KooroshTorabi/KMSwitch/docs/board-a-front.png

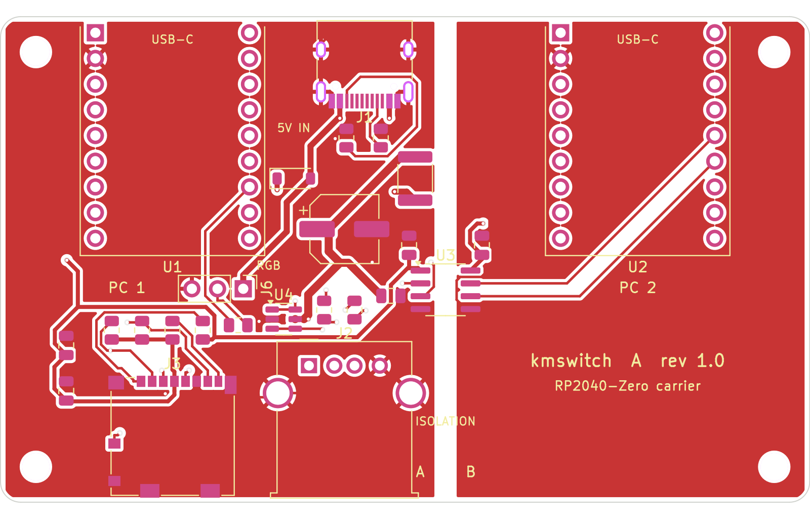
docs/board-a-front.png
