KooroshTorabi/KMSwitch/docs/case-a-back.png

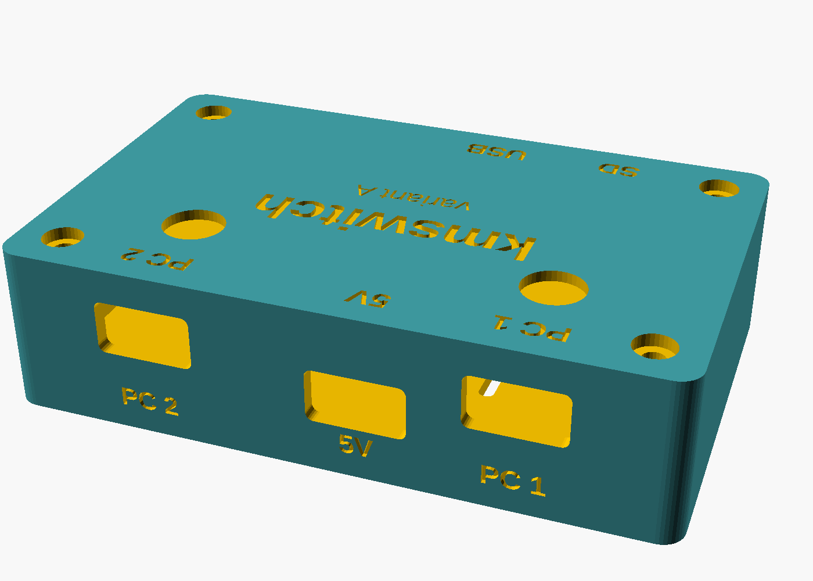
docs/case-a-back.png
