KooroshTorabi/KMSwitch/docs/case-a-front.png

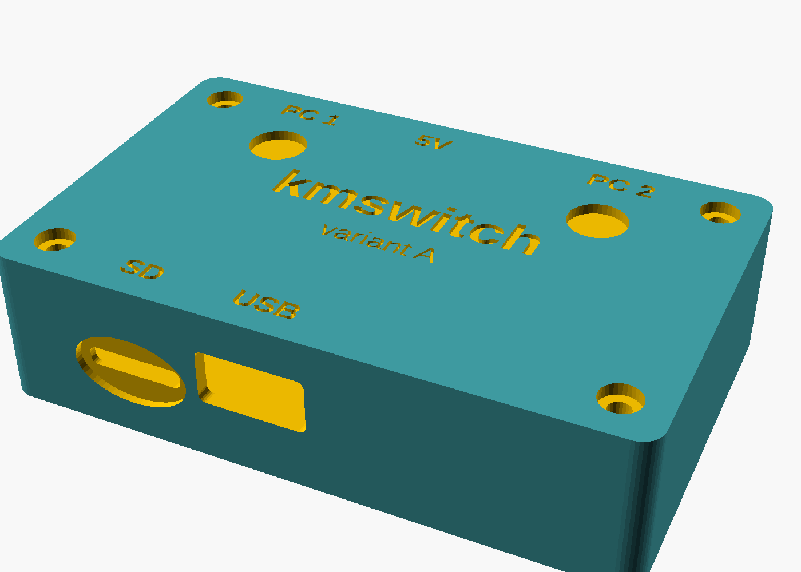
docs/case-a-front.png
