KooroshTorabi/KMSwitch/docs/case-b-back.png

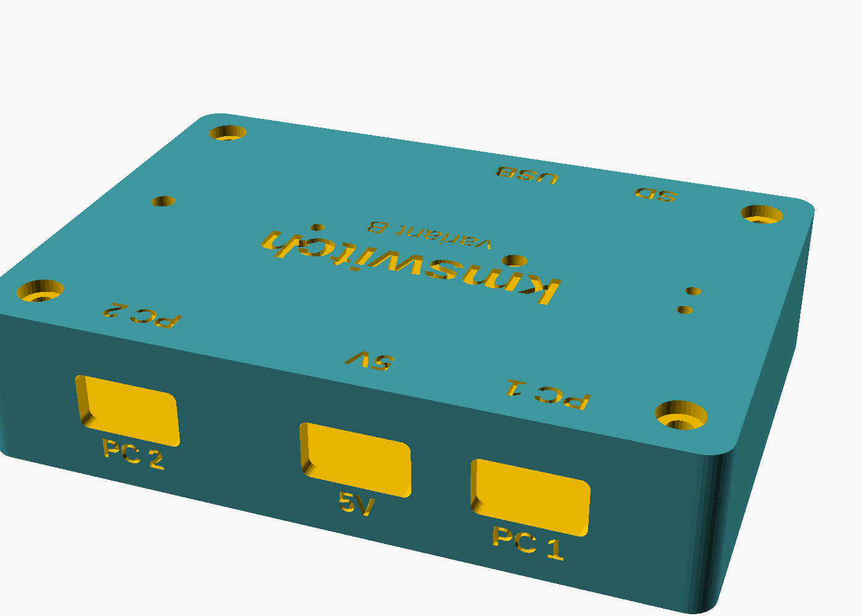
docs/case-b-back.png
