KooroshTorabi/KMSwitch/docs/case-b-front.png

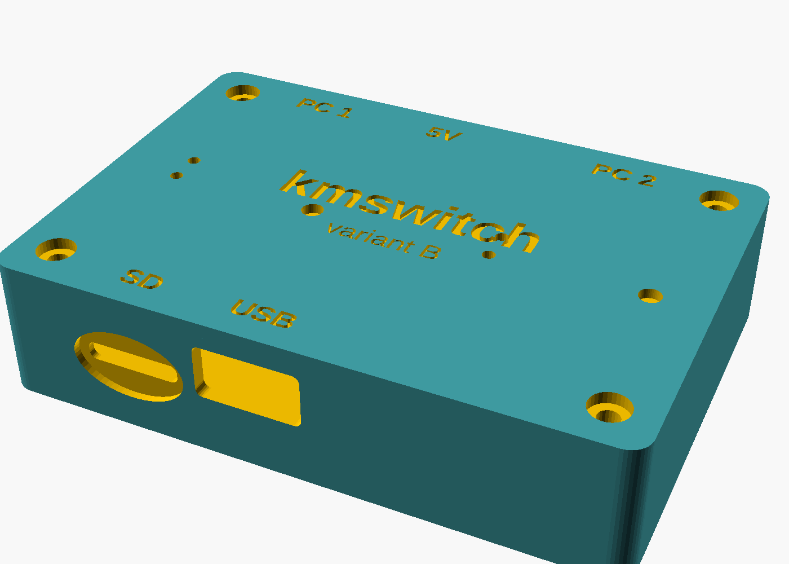
docs/case-b-front.png
