KooroshTorabi/KMSwitch/hardware/variant-a-rp2040-zero/fab/kmswitch-a-back.png

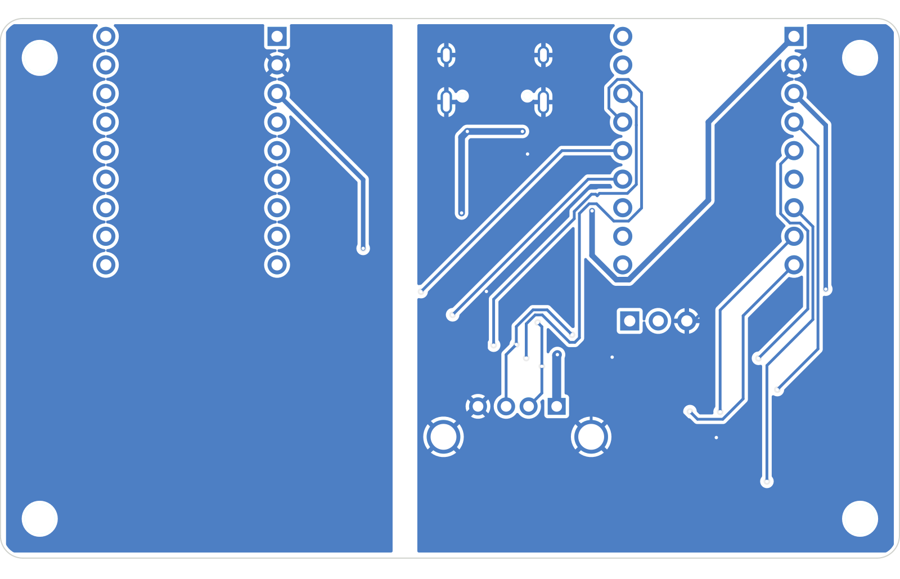
hardware/variant-a-rp2040-zero/fab/kmswitch-a-back.png
