KooroshTorabi/KMSwitch/hardware/variant-b-rp2040/fab/kmswitch-b-back.png

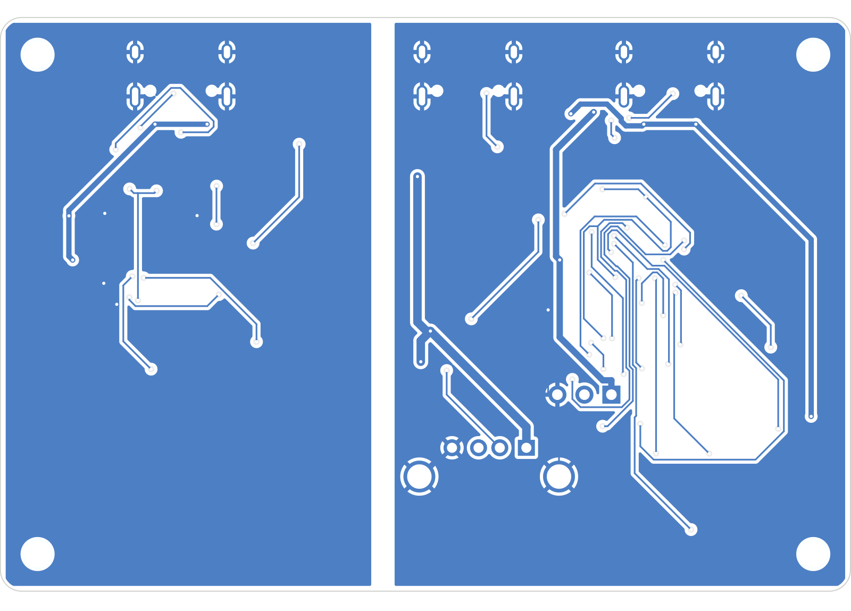
hardware/variant-b-rp2040/fab/kmswitch-b-back.png
