KooroshTorabi/KMSwitch/hardware/variant-b-rp2040/fab/kmswitch-b-bom.csv

Comment | Designator | Footprint | Quantity | LCSC Part # | Notes
100uF 10V | C1 | CP_Elec_6.3x7.7 | 1 | C294520 | VT1V101M-CRE77, 100uF 35V 6.3x7.7 (higher voltage is fine)
100nF | C2 | C_0805_2012Metric | 1 | C49678
100nF | C3,C4,C6,C14,C15,C16,C17,C18,C19,C20,C21,C24,C25,C54,C55,C56,C57,C58,C59,C60,C61,C64,C65 | C_0603_1608Metric | 23 | C14663
10uF | C5,C26,C27,C66,C67 | C_0805_2012Metric | 5 | C15850
15pF | C11,C12,C51,C52 | C_0603_1608Metric | 4 | C1644
1uF | C22,C23,C62,C63 | C_0603_1608Metric | 4 | C15849
SS34 | D2,D3 | D_SMA | 2 | C8678
red | D37,D77 | LED_0603_1608Metric | 2 | C2286 | KT-0603R
green | D38,D78 | LED_0603_1608Metric | 2 | C12624 | KT-0603G
blue | D39,D79 | LED_0603_1608Metric | 2 | C2288 | KT-0603B
2A hold (1812) | F1 | Fuse_1812_4532Metric | 1 | C545213 | SMD1812P200TF/16, 2A hold 16V
USB-C 5V IN | J1 | USB_C_Receptacle_HRO_TYPE-C-31-M-12 | 1 | C165948
USB-A host (hub/keyboard) | J2 | USB_A_Molex_67643_Horizontal | 1 | n/a | Molex 67643-0910 through-hole (Mouser/DigiKey/TME), hand-solder
104031-0811 | J3 | microSD_HC_Molex_104031-0811 | 1 | C585350
USB-C to PC 1 | J4 | USB_C_Receptacle_HRO_TYPE-C-31-M-12 | 1 | C165948
USB-C to PC 2 | J5 | USB_C_Receptacle_HRO_TYPE-C-31-M-12 | 1 | C165948
RGB LED (WS2812): 5V DIN GND | J6 | PinHeader_1x03_P2.54mm_Vertical | 1 | n/a | optional 3-pin header, not assembled (DNP)
5.1k | R1,R2 | R_0805_2012Metric | 2 | C27834
22R | R3,R4 | R_0603_1608Metric | 2 | C23345
10k | R5,R6,R7,R8,R32,R42,R72 | R_0603_1608Metric | 7 | C25804
330R | R9,R38,R78 | R_0603_1608Metric | 3 | C23138
1k | R13,R30,R37,R53,R70,R77 | R_0603_1608Metric | 6 | C21190
27R | R28,R29,R68,R69 | R_0603_1608Metric | 4 | C25190 | 0603WAF270JT5E
100R | R39,R79 | R_0603_1608Metric | 2 | C22775 | 0603WAF1000T5E
5.1k | R40,R41,R44,R45 | R_0603_1608Metric | 4 | C23186
20k | R43 | R_0603_1608Metric | 1 | C4184
BOOTSEL | SW31,SW71 | SW_SPST_PTS810 | 2 | C116501 | PTS810SJM250SMTRLFS
RESET | SW33,SW73 | SW_SPST_PTS810 | 2 | C116501 | PTS810SJM250SMTRLFS
CA-IS3721HS | U3 | SOIC-8_3.9x4.9mm_P1.27mm | 1 | C428884
USBLC6-2SC6 | U4,U5,U6 | SOT-23-6 | 3 | C7519
RP2040 | U10,U50 | QFN-56-1EP_7x7mm_P0.4mm_EP3.2x3.2mm | 2 | C2040
W25Q16JVSSIQ (2 MB) | U11,U51 | SOIC-8_5.23x5.23mm_P1.27mm | 2 | C131024
AP2112K-3.3 | U12,U52 | SOT-23-5 | 2 | C51118
12MHz | Y10,Y50 | Crystal_SMD_3225-4Pin_3.2x2.5mm | 2 | C9002
