KooroshTorabi/KMSwitch/enclosure/stl/kmswitch-b-lid.stl

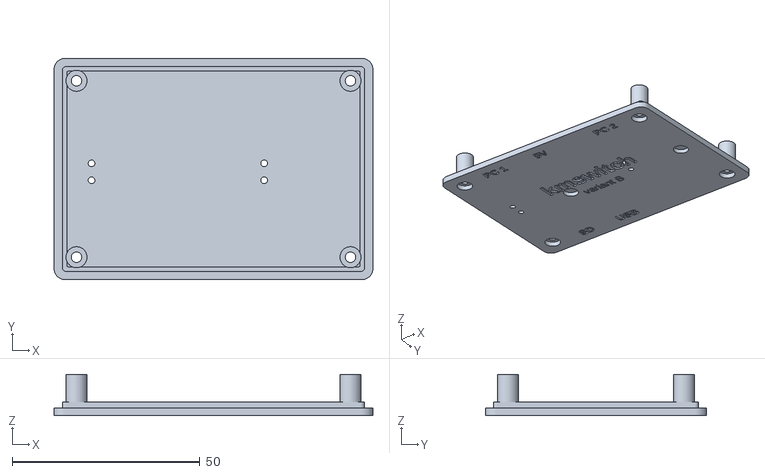
[picture p14: CAD file, 2026-11-04]
enclosure/stl/kmswitch-b-lid.stl
85.0 x 59.0 x 11.0
