KooroshTorabi/KMSwitch/enclosure/stl/kmswitch-a-lid.stl

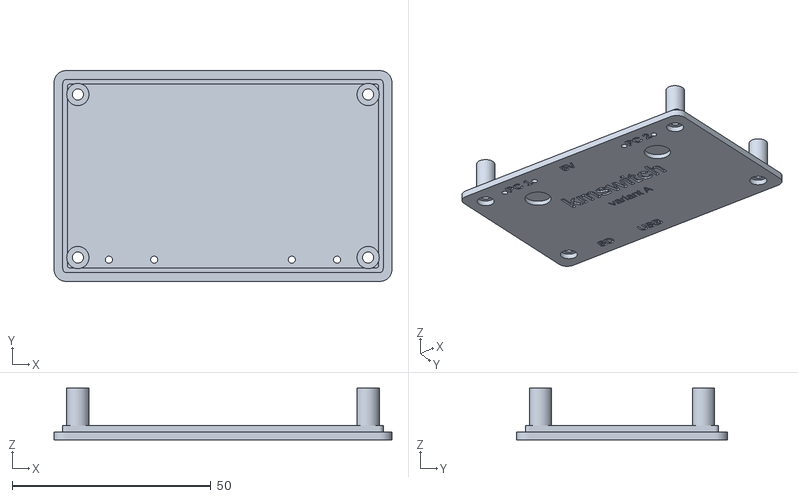
[picture p15: CAD file, 2026-11-04]
enclosure/stl/kmswitch-a-lid.stl
85.0 x 53.0 x 13.0
