KooroshTorabi/KMSwitch/enclosure/stl/kmswitch-b-bottom.stl

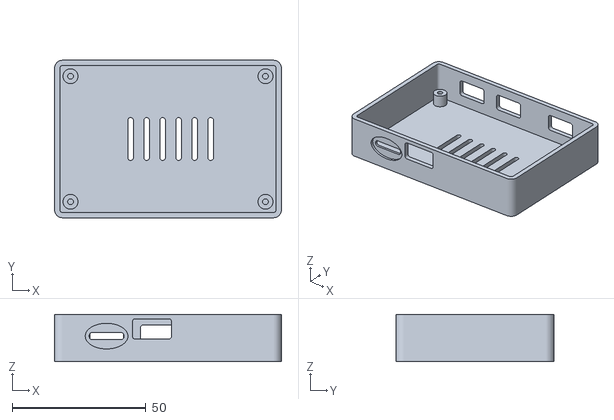
[picture p16: CAD file, 2026-11-02]
enclosure/stl/kmswitch-b-bottom.stl
85.0 x 59.0 x 17.6
