KooroshTorabi/KMSwitch/enclosure/stl/kmswitch-a-bottom.stl

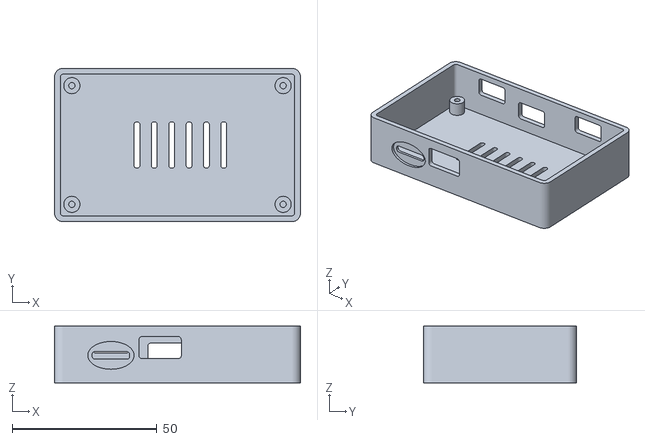
[picture p17: CAD file, 2026-11-02]
enclosure/stl/kmswitch-a-bottom.stl
85.0 x 53.0 x 19.6
