KooroshTorabi/KMSwitch/hardware/variant-a-rp2040-zero/fab/kmswitch-a-schematic.pdf

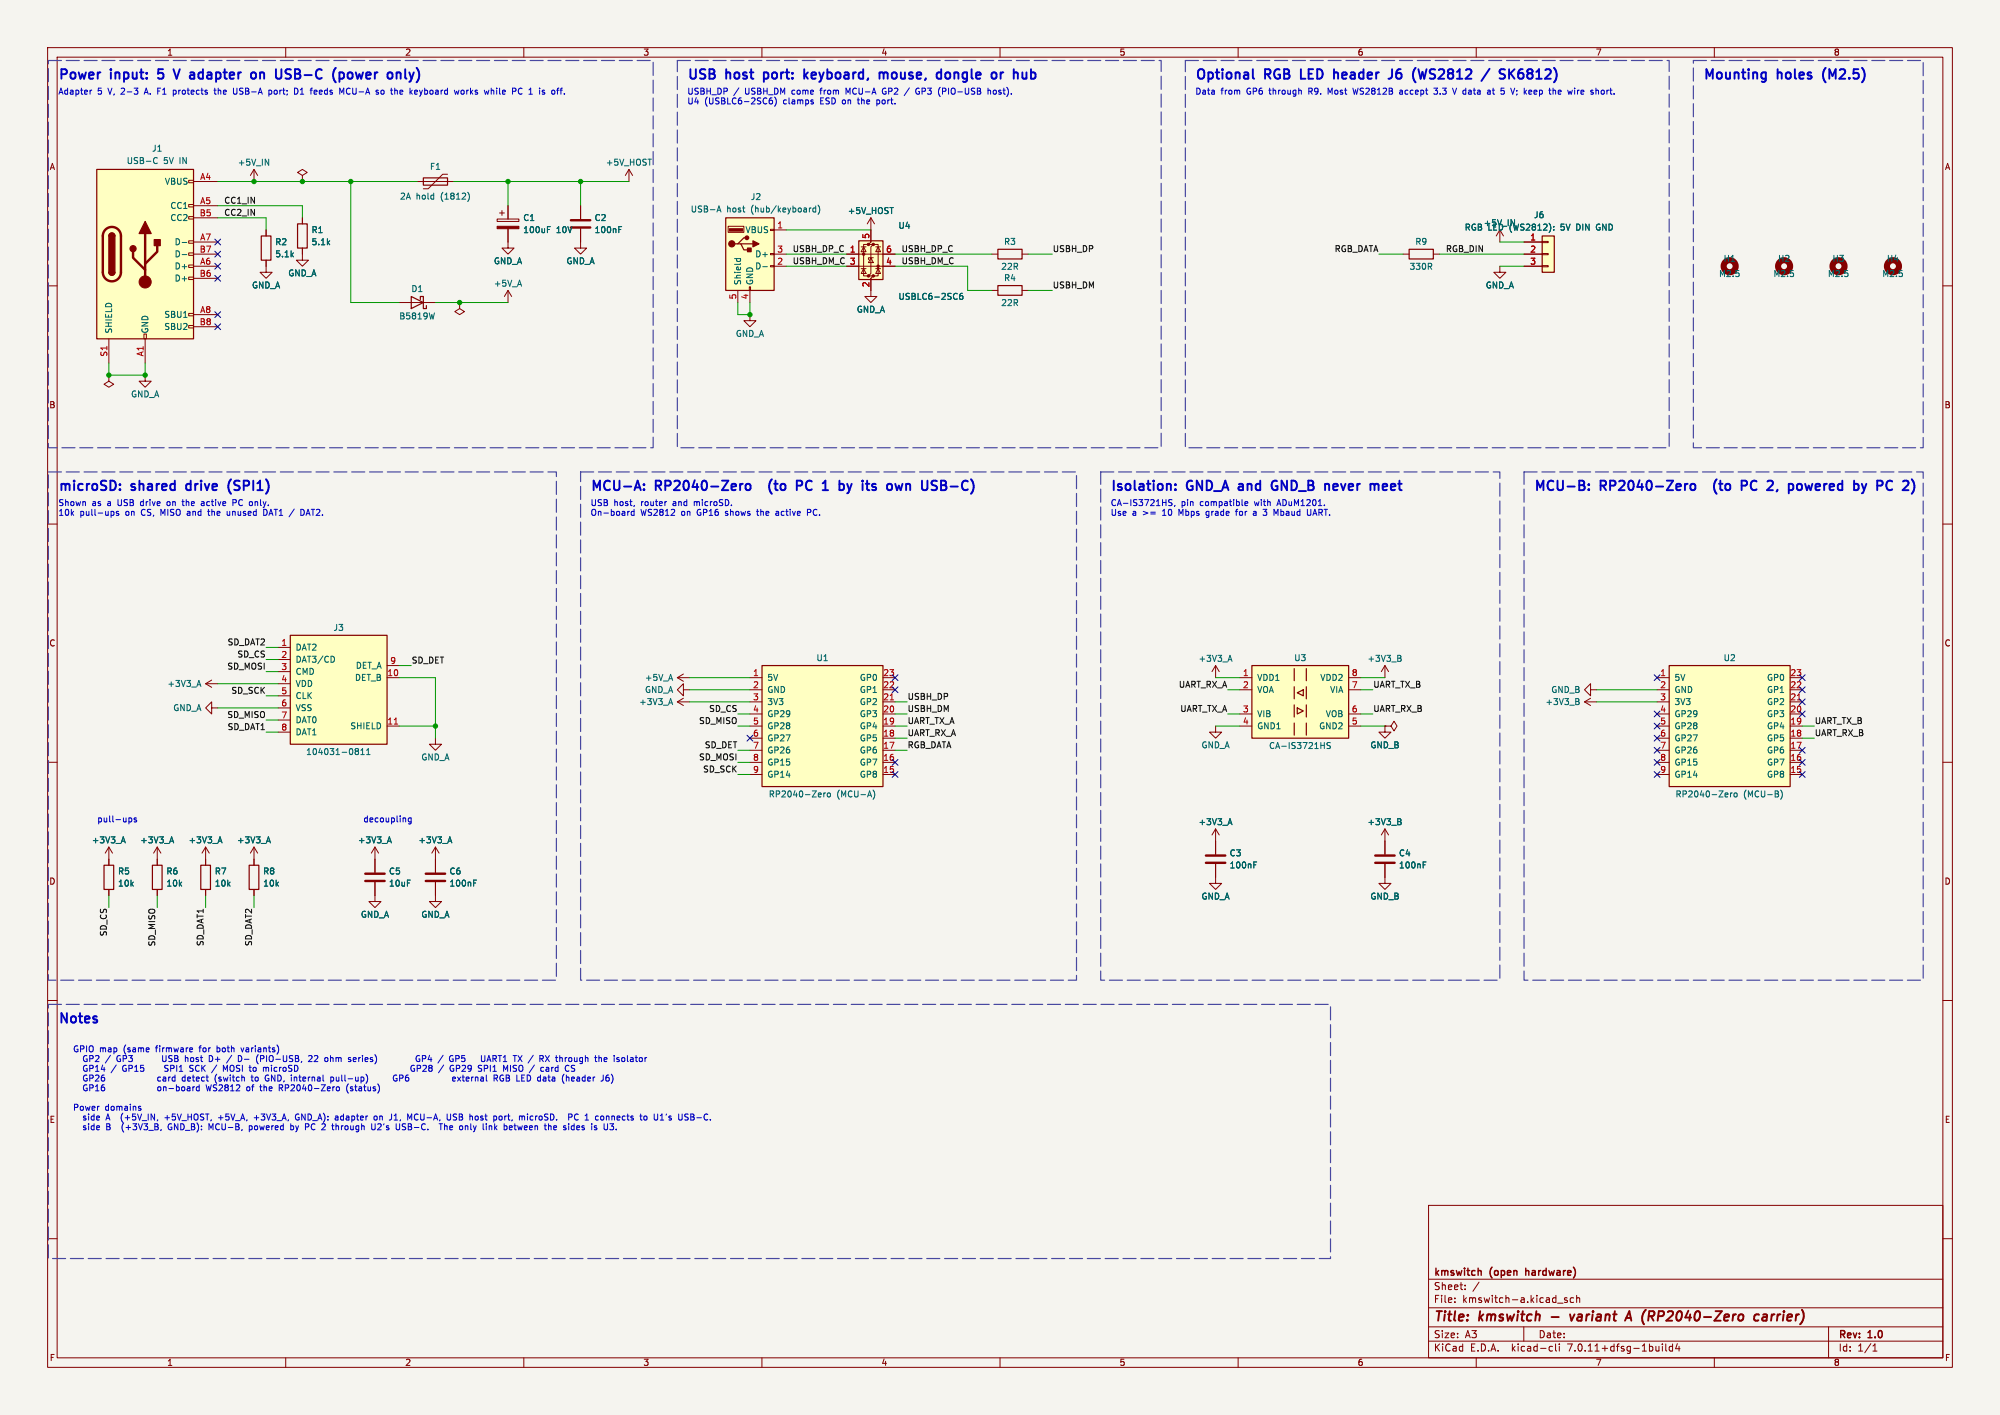
[picture p19: page 1]

USB host port: keyboard, mouse, dongle or hub

J2 USB-A host (hub/keyboard) R2
