KooroshTorabi/KMSwitch/hardware/variant-a-rp2040-zero/kmswitch-a.kicad_pcb

## KiCad design hardware/variant-a-rp2040-zero/kmswitch-a.kicad_pcb (2026-11-04)

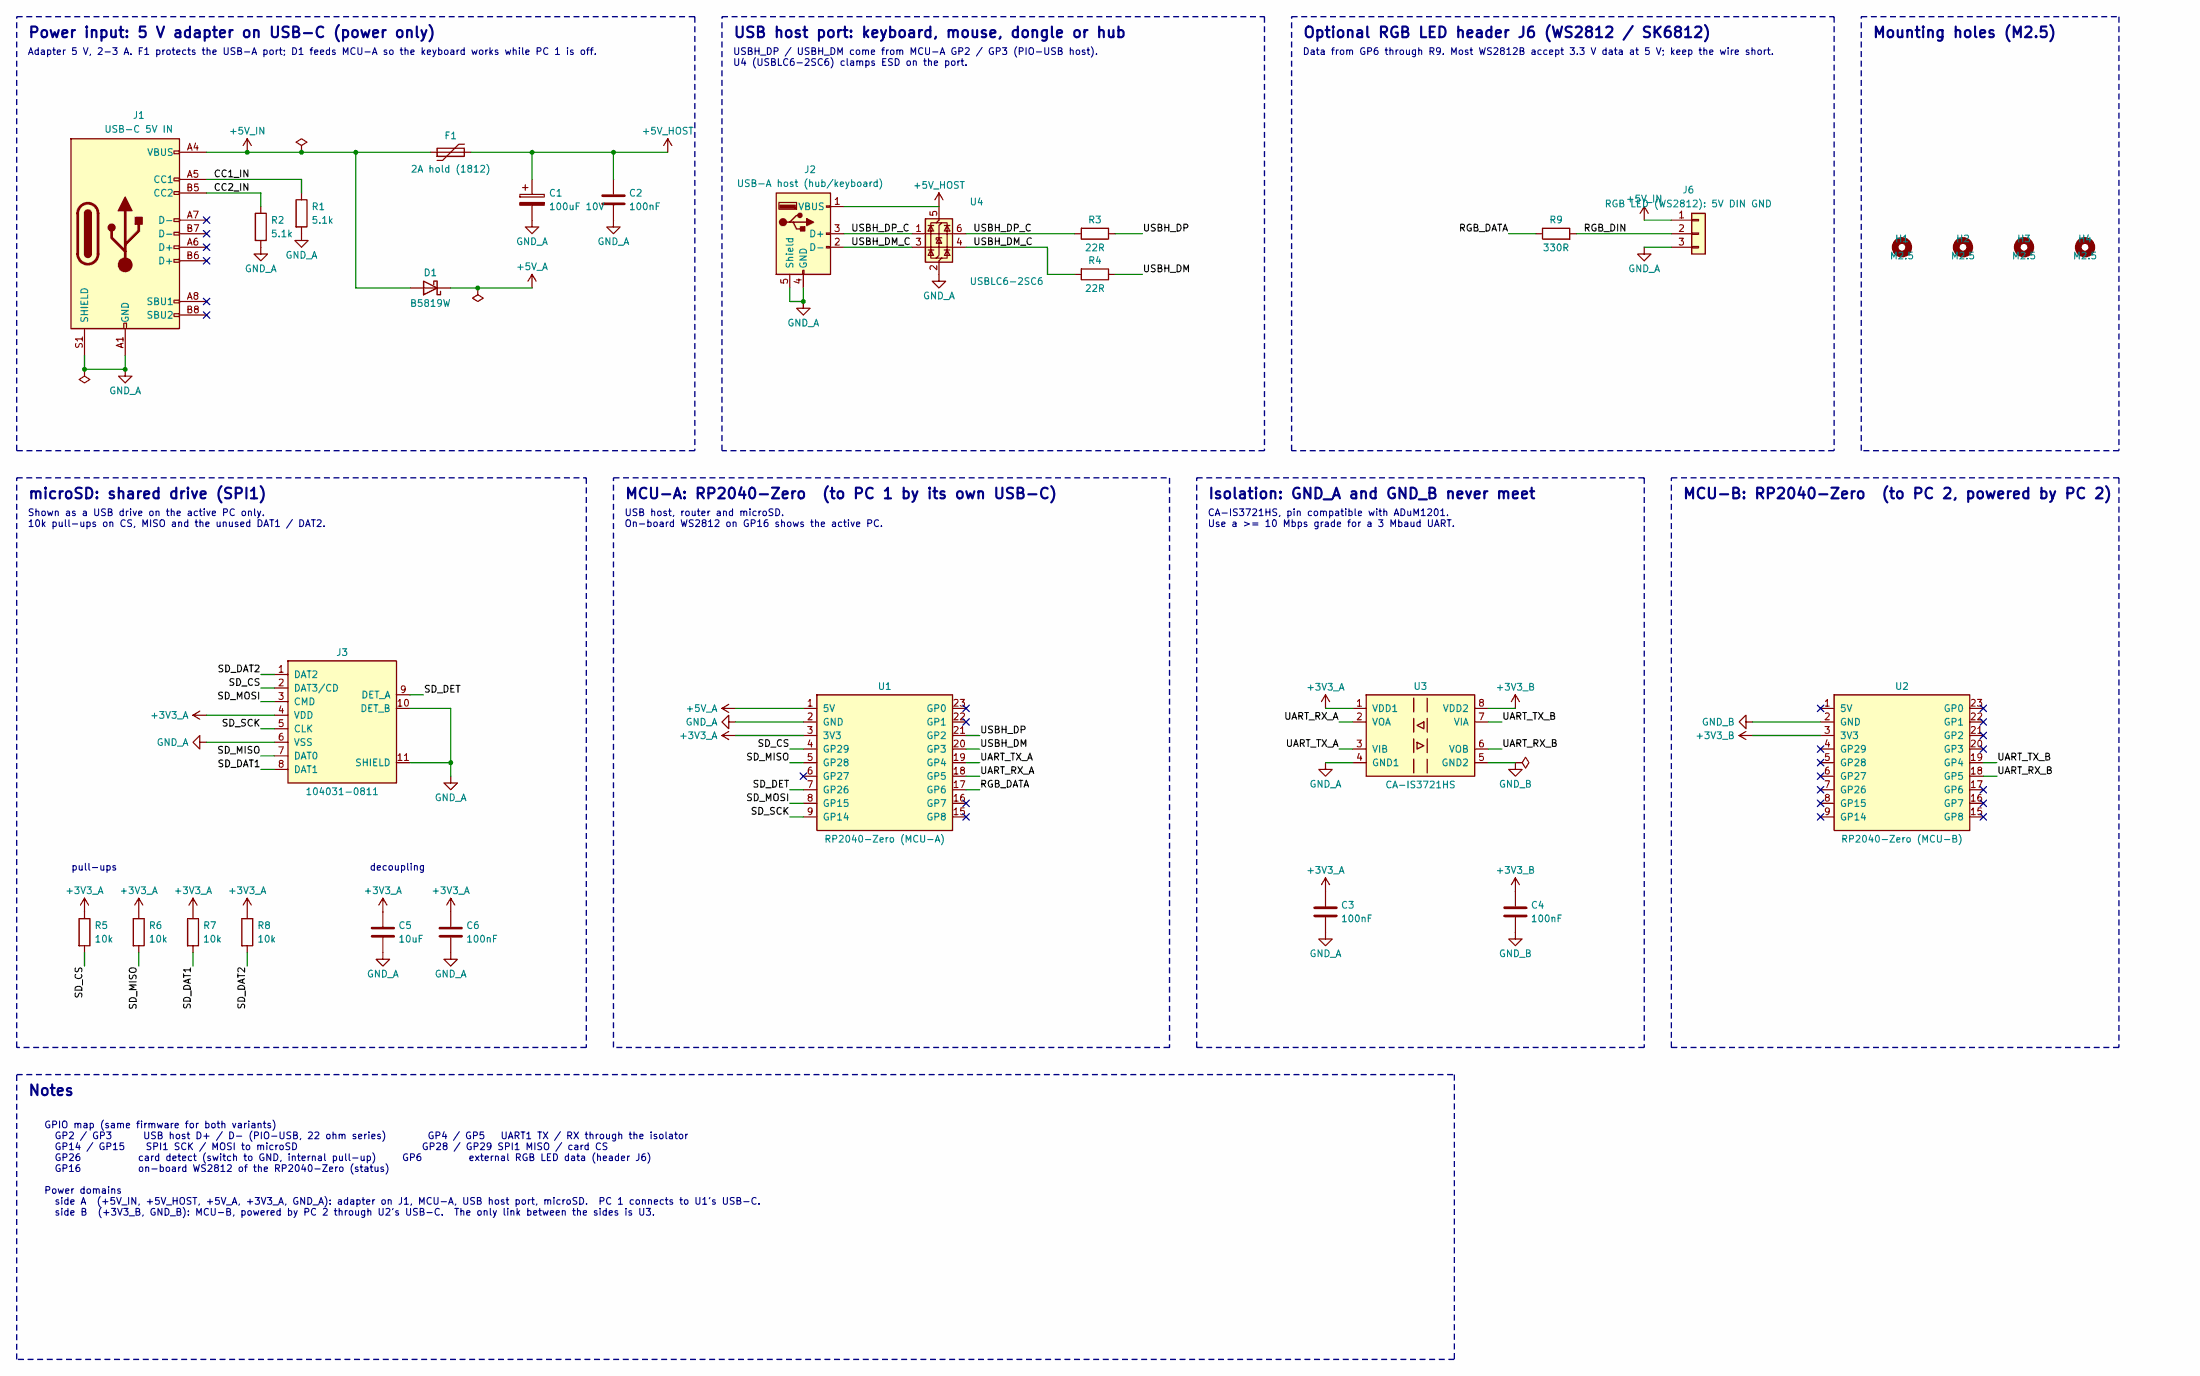
[picture p20: schematic kmswitch-a.kicad_sch, kmswitch - variant A (RP2040-Zero carrier)]

Parts:
C1: 100uF 10V; CP_Elec_6.3x7.7
C2, C3, C4, C6: 100nF; C_0805_2012Metric
C5: 10uF; C_0805_2012Metric
D1: B5819W; D_SOD-123
F1: 2A hold (1812); Fuse_1812_4532Metric
H1, H2, H3, H4: M2.5; MountingHole_2.7mm_M2.5
J1: USB-C 5V IN; USB_C_Receptacle_HRO_TYPE-C-31-M-12; LCSC C165948
J2: USB-A host (hub/keyboard); USB_A_Molex_67643_Horizontal
J3: 104031-0811; microSD_HC_Molex_104031-0811
J6: RGB LED (WS2812): 5V DIN GND; PinHeader_1x03_P2.54mm_Vertical
R1, R2: 5.1k; R_0805_2012Metric
R3, R4: 22R; R_0805_2012Metric
R5, R6, R7, R8: 10k; R_0805_2012Metric
R9: 330R; R_0805_2012Metric
U1: RP2040-Zero (MCU-A); RP2040-Zero_Module
U2: RP2040-Zero (MCU-B); RP2040-Zero_Module
U3: CA-IS3721HS; SOIC-8_3.9x4.9mm_P1.27mm; LCSC C428884
U4: USBLC6-2SC6; SOT-23-6; LCSC C7519

Connections:
+3V3_A: C3.1, C5.1, C6.1, J3.4 (VDD), R5.1, R6.1, R7.1, R8.1, U1.3 (3V3), U3.1 (VDD1)
+3V3_B: C4.1, U2.3 (3V3), U3.8 (VDD2)
+5V_A: D1.1 (K), U1.1 (5V)
+5V_HOST: C1.1, C2.1, F1.2, J2.1 (VBUS), U4.5 (VBUS)
+5V_IN: D1.2 (A), F1.1, J1.A4 (VBUS), J1.A9 (VBUS), J1.B4 (VBUS), J1.B9 (VBUS), J6.1
CC1_IN: J1.A5 (CC1), R1.1
CC2_IN: J1.B5 (CC2), R2.1
GND_A: C1.2, C2.2, C3.2, C5.2, C6.2, J1.A1 (GND), J1.A12 (GND), J1.B1 (GND), J1.B12 (GND), J1.S1 (SHIELD), J2.4 (GND), J2.5 (Shield), J3.6 (VSS), J3.10 (DET_B), J3.11 (SHIELD), J6.3, R1.2, R2.2, U1.2 (GND), U3.4 (GND1), U4.2 (GND)
GND_B: C4.2, U2.2 (GND), U3.5 (GND2)
RGB_DATA: R9.1, U1.17 (GP6)
RGB_DIN: J6.2, R9.2
SD_CS: J3.2 (DAT3/CD), R5.2, U1.4 (GP29)
SD_DAT1: J3.8 (DAT1), R7.2
SD_DAT2: J3.1 (DAT2), R8.2
SD_DET: J3.9 (DET_A), U1.7 (GP26)
SD_MISO: J3.7 (DAT0), R6.2, U1.5 (GP28)
SD_MOSI: J3.3 (CMD), U1.8 (GP15)
SD_SCK: J3.5 (CLK), U1.9 (GP14)
UART_RX_A: U1.18 (GP5), U3.2 (VOA)
UART_RX_B: U2.18 (GP5), U3.6 (VOB)
UART_TX_A: U1.19 (GP4), U3.3 (VIB)
UART_TX_B: U2.19 (GP4), U3.7 (VIA)
USBH_DM: R4.1, U1.20 (GP3)
USBH_DM_C: J2.2 (D-), R4.2, U4.3 (I/O2), U4.4 (I/O2)
USBH_DP: R3.1, U1.21 (GP2)
USBH_DP_C: J2.3 (D+), R3.2, U4.1 (I/O1), U4.6 (I/O1)

Notes on the sheet:
Power input: 5 V adapter on USB-C (power only)
Adapter 5 V, 2-3 A. F1 protects the USB-A port; D1 feeds MCU-A so the keyboard works while PC 1 is off.
USB host port: keyboard, mouse, dongle or hub
USBH_DP / USBH_DM come from MCU-A GP2 / GP3 (PIO-USB host). U4 (USBLC6-2SC6) clamps ESD on the port.
Optional RGB LED header J6 (WS2812 / SK6812)
Data from GP6 through R9. Most WS2812B accept 3.3 V data at 5 V; keep the wire short.
Mounting holes (M2.5)
microSD: shared drive (SPI1)
Shown as a USB drive on the active PC only. 10k pull-ups on CS, MISO and the unused DAT1 / DAT2.
pull-ups
decoupling
MCU-A: RP2040-Zero (to PC 1 by its own USB-C)
USB host, router and microSD. On-board WS2812 on GP16 shows the active PC.
Isolation: GND_A and GND_B never meet
CA-IS3721HS, pin compatible with ADuM1201. Use a >= 10 Mbps grade for a 3 Mbaud UART.
MCU-B: RP2040-Zero (to PC 2, powered by PC 2)
Notes
GPIO map (same firmware for both variants) GP2 / GP3 USB host D+ / D- (PIO-USB, 22 ohm series) GP4 / GP5 UART1 TX / RX through the isolator GP14 / GP15 SPI1 SCK / MOSI to microSD GP28 / GP29 SPI1 MISO / card CS GP26 card detect (switch to GND, internal pull-up) GP6 external RGB LED data (header J6)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

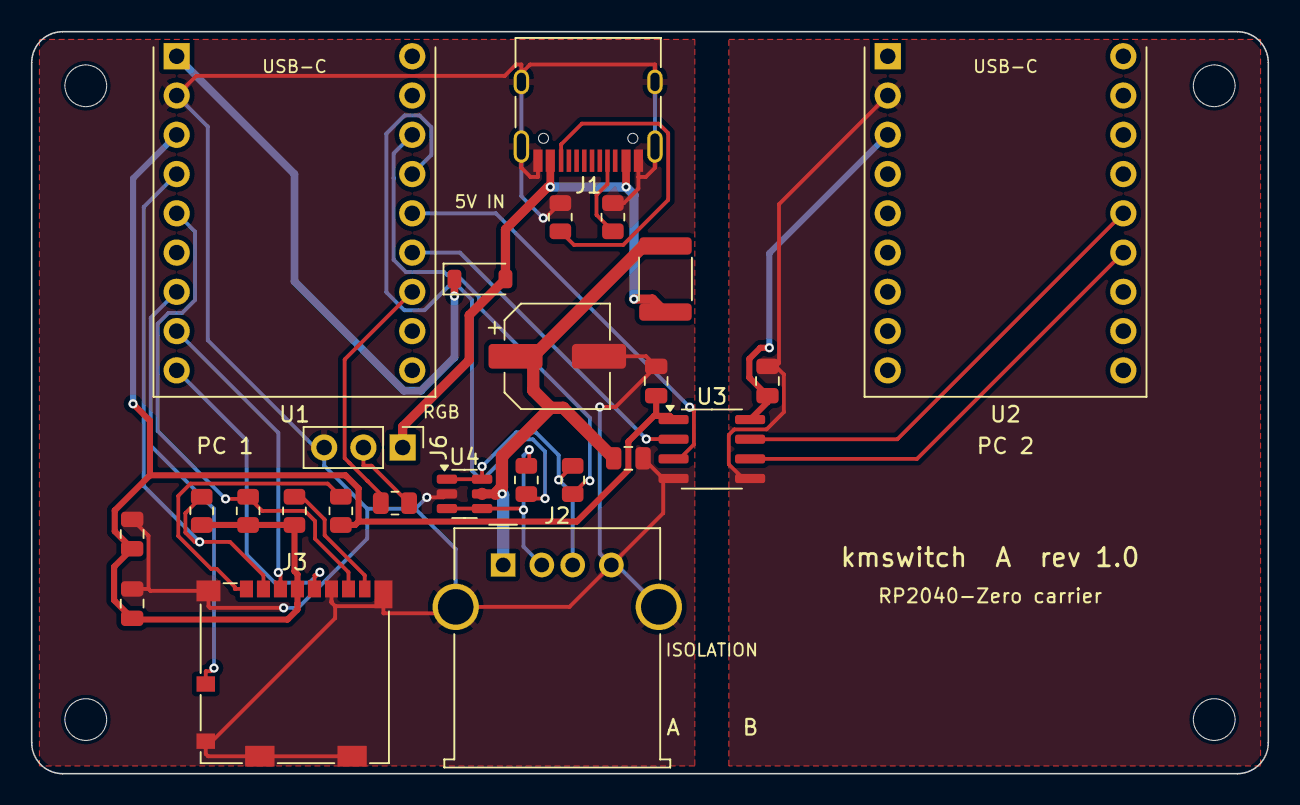
[picture p21: board kmswitch-a.kicad_pcb from above]

Board: 2 copper layers, 80.0 x 48.0 mm, 29 parts (0 on the bottom side), 26 nets.
