KooroshTorabi/KMSwitch/hardware/variant-b-rp2040/kmswitch-b.kicad_pcb

## KiCad design hardware/variant-b-rp2040/kmswitch-b.kicad_pcb (2026-11-04)

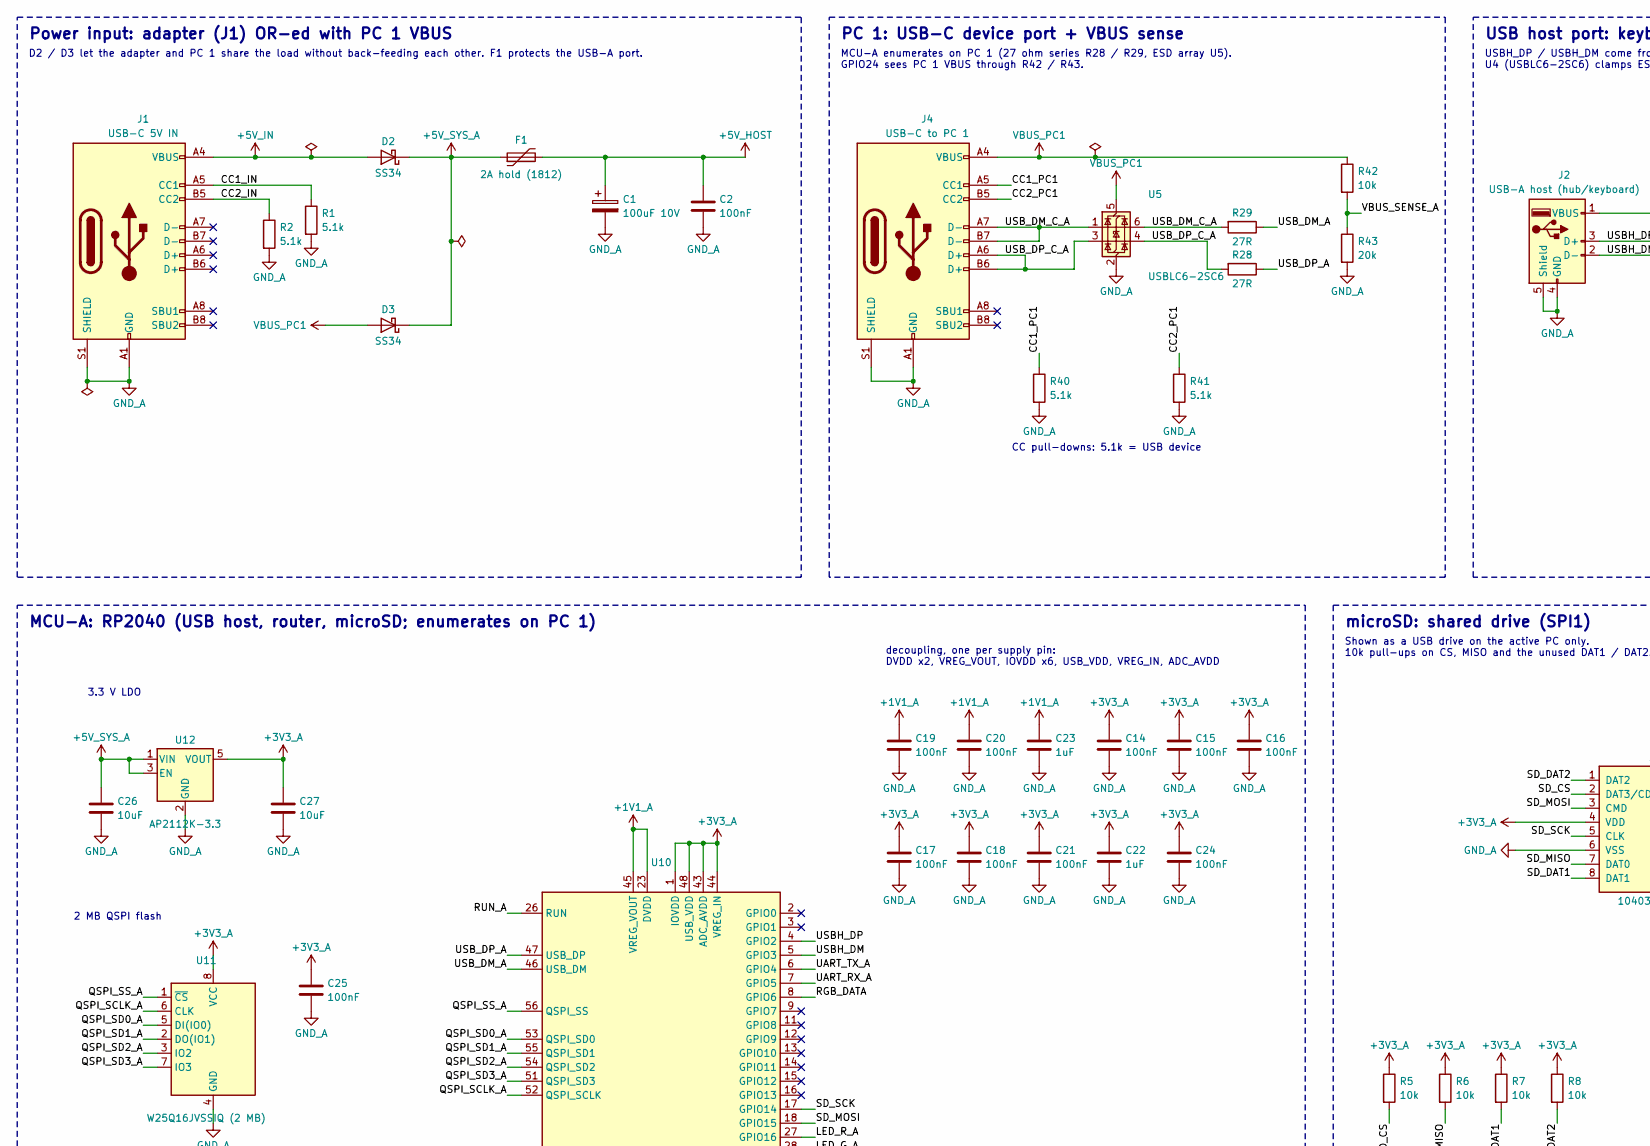
[picture p22: schematic kmswitch-b.kicad_sch, kmswitch - variant B (2x RP2040 chip-down), part in row 1, column 1]

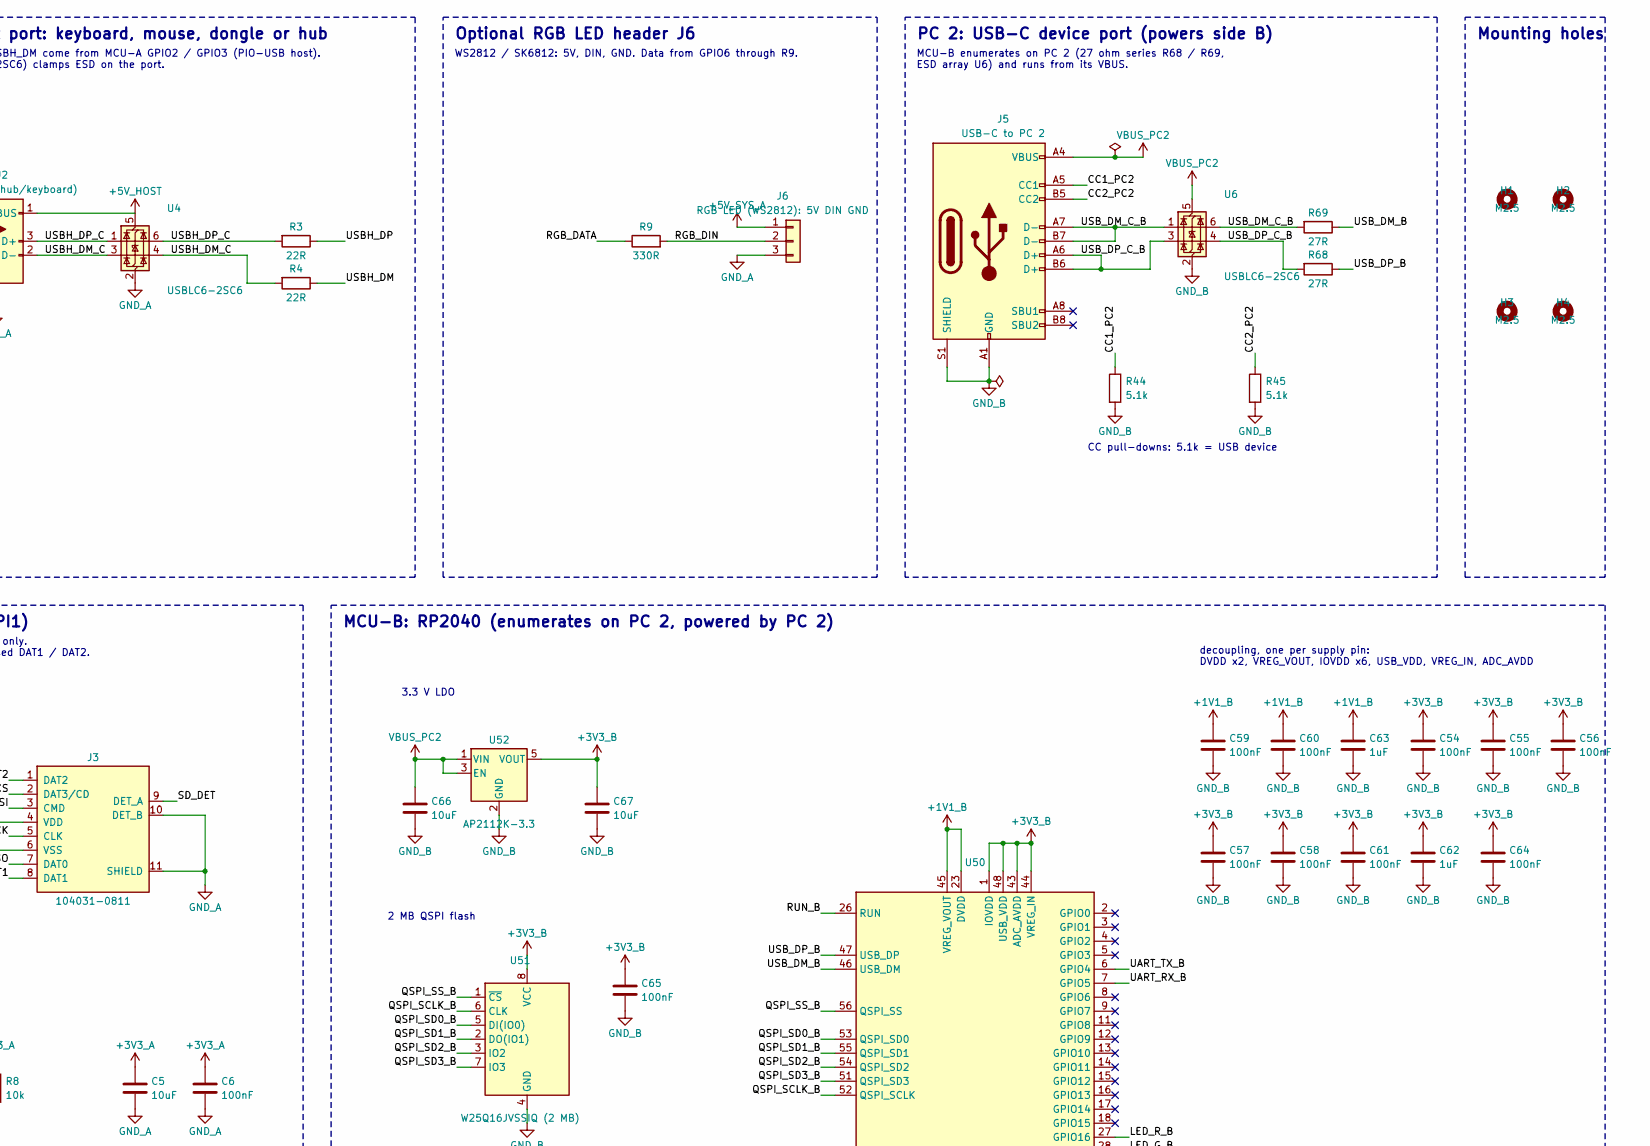
[picture p23: schematic kmswitch-b.kicad_sch, kmswitch - variant B (2x RP2040 chip-down), part in row 1, column 2]

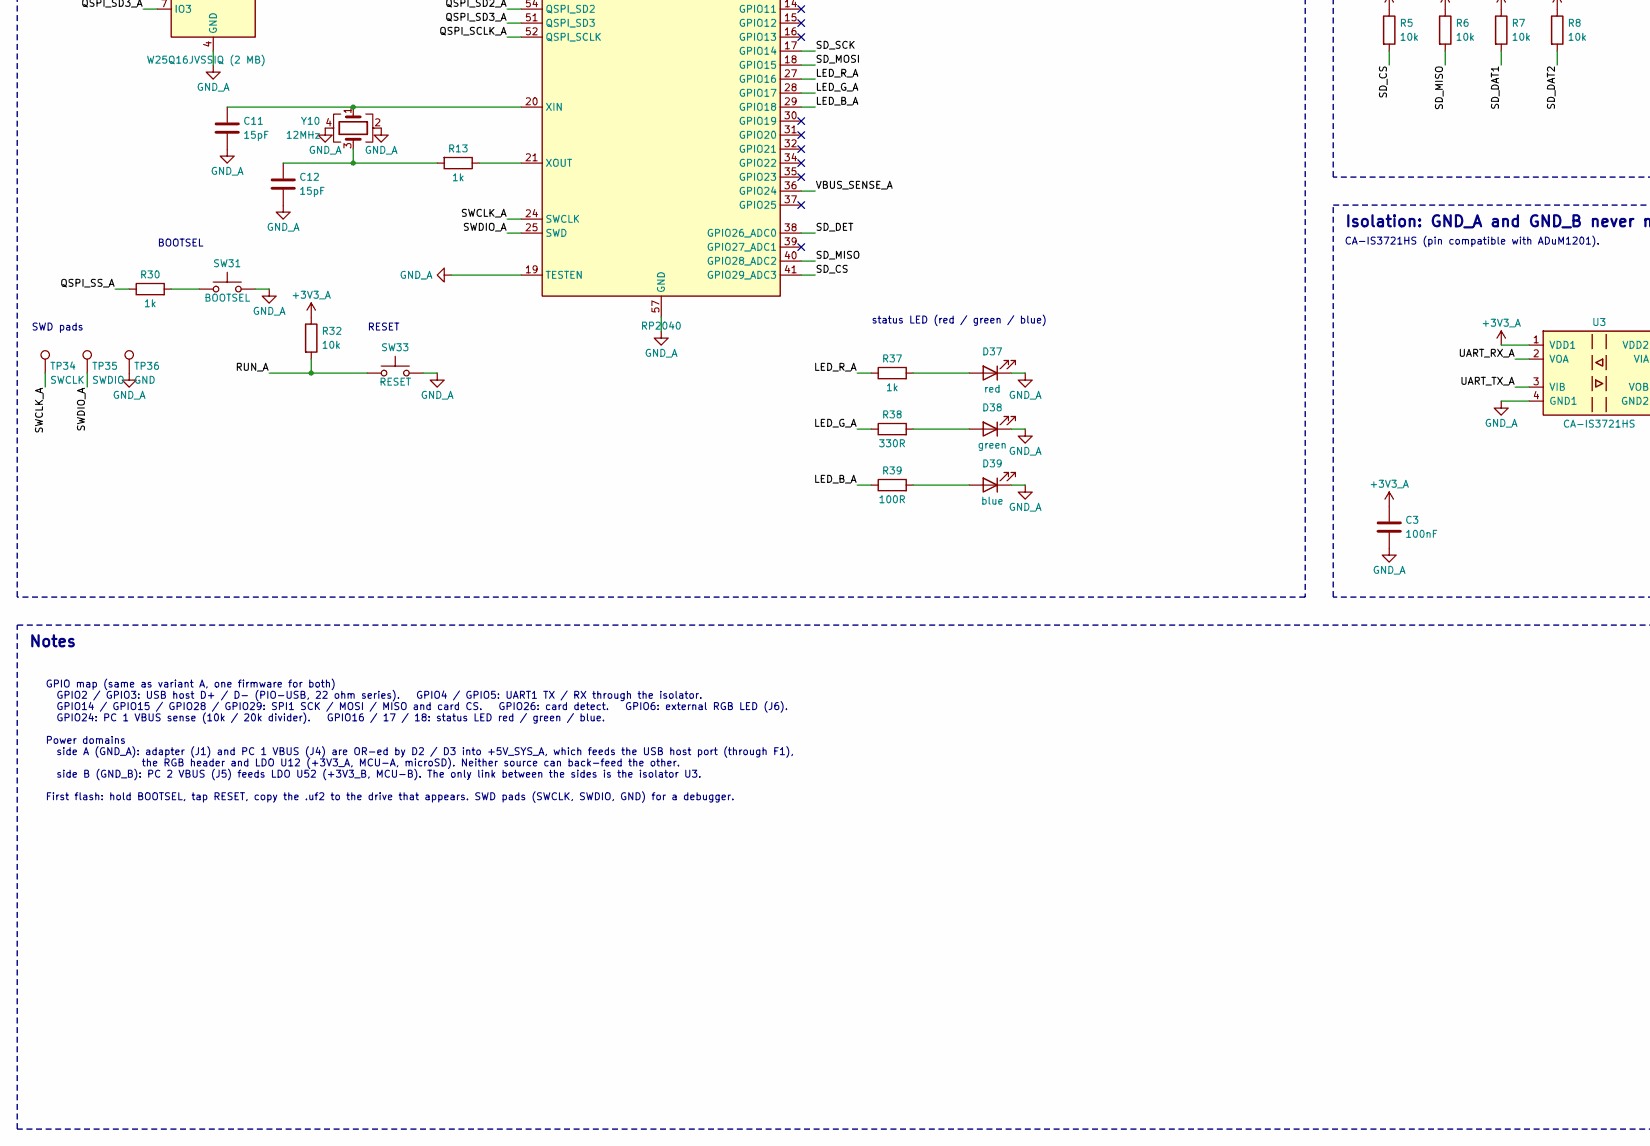
[picture p24: schematic kmswitch-b.kicad_sch, kmswitch - variant B (2x RP2040 chip-down), part in row 2, column 1]

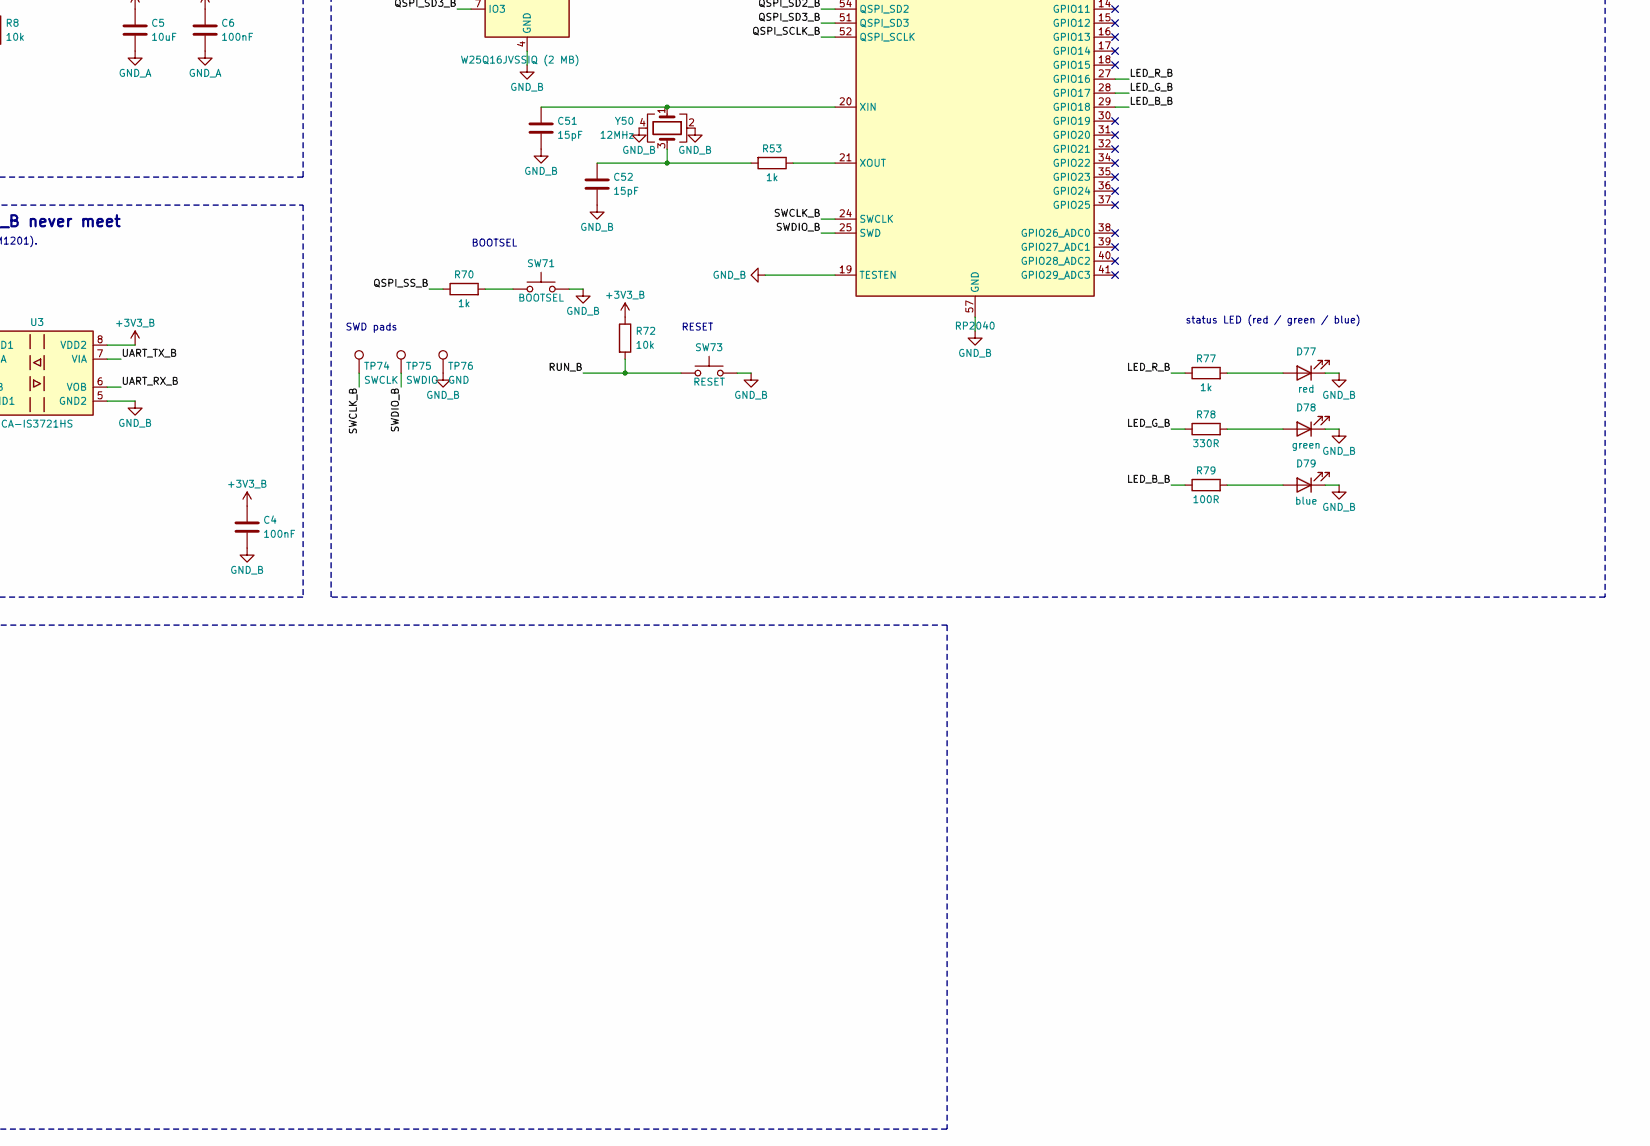
[picture p25: schematic kmswitch-b.kicad_sch, kmswitch - variant B (2x RP2040 chip-down), part in row 2, column 2]

Parts:
C1: 100uF 10V; CP_Elec_6.3x7.7
C2: 100nF; C_0805_2012Metric
C3, C4, C6, C14, C15, C16, C17, C18, C19, C20, C21, C24, C25, C54, C55, C56, C57, C58, C59, C60, C61, C64, C65: 100nF; C_0603_1608Metric
C5, C26, C27, C66, C67: 10uF; C_0805_2012Metric
C11, C12, C51, C52: 15pF; C_0603_1608Metric
C22, C23, C62, C63: 1uF; C_0603_1608Metric
D2, D3: SS34; D_SMA; LCSC C8678
D37, D77: red; LED_0603_1608Metric
D38, D78: green; LED_0603_1608Metric
D39, D79: blue; LED_0603_1608Metric
F1: 2A hold (1812); Fuse_1812_4532Metric
H1, H2, H3, H4: M2.5; MountingHole_2.7mm_M2.5
J1: USB-C 5V IN; USB_C_Receptacle_HRO_TYPE-C-31-M-12; LCSC C165948
J2: USB-A host (hub/keyboard); USB_A_Molex_67643_Horizontal
J3: 104031-0811; microSD_HC_Molex_104031-0811
J4: USB-C to PC 1; USB_C_Receptacle_HRO_TYPE-C-31-M-12; LCSC C165948
J5: USB-C to PC 2; USB_C_Receptacle_HRO_TYPE-C-31-M-12; LCSC C165948
J6: RGB LED (WS2812): 5V DIN GND; PinHeader_1x03_P2.54mm_Vertical
R1, R2: 5.1k; R_0805_2012Metric
R3, R4: 22R; R_0603_1608Metric
R5, R6, R7, R8, R32, R42, R72: 10k; R_0603_1608Metric
R9, R38, R78: 330R; R_0603_1608Metric
R13, R30, R37, R53, R70, R77: 1k; R_0603_1608Metric
R28, R29, R68, R69: 27R; R_0603_1608Metric
R39, R79: 100R; R_0603_1608Metric
R40, R41, R44, R45: 5.1k; R_0603_1608Metric
R43: 20k; R_0603_1608Metric
SW31, SW71: BOOTSEL; SW_SPST_PTS810
SW33, SW73: RESET; SW_SPST_PTS810
TP34, TP74: SWCLK; TestPoint_Pad_D1.0mm
TP35, TP75: SWDIO; TestPoint_Pad_D1.0mm
TP36, TP76: GND; TestPoint_Pad_D1.0mm
U3: CA-IS3721HS; SOIC-8_3.9x4.9mm_P1.27mm; LCSC C428884
U4, U5, U6: USBLC6-2SC6; SOT-23-6; LCSC C7519
U10, U50: RP2040; QFN-56-1EP_7x7mm_P0.4mm_EP3.2x3.2mm; LCSC C2040
U11, U51: W25Q16JVSSIQ (2 MB); SOIC-8_5.23x5.23mm_P1.27mm; LCSC C131024
U12, U52: AP2112K-3.3; SOT-23-5; LCSC C51118
Y10, Y50: 12MHz; Crystal_SMD_3225-4Pin_3.2x2.5mm; LCSC C9002

Connections:
+1V1_A: C19.1, C20.1, C23.1, U10.23 (DVDD), U10.45 (VREG_VOUT), U10.50 (DVDD)
+1V1_B: C59.1, C60.1, C63.1, U50.23 (DVDD), U50.45 (VREG_VOUT), U50.50 (DVDD)
+3V3_A: C3.1, C5.1, C6.1, C14.1, C15.1, C16.1, C17.1, C18.1, C21.1, C22.1, C24.1, C25.1, C27.1, J3.4 (VDD), R5.1, R6.1, R7.1, R8.1, R32.1, U3.1 (VDD1), U10.1 (IOVDD), U10.10 (IOVDD), U10.22 (IOVDD), U10.33 (IOVDD), U10.42 (IOVDD), U10.43 (ADC_AVDD), U10.44 (VREG_IN), U10.48 (USB_VDD), U10.49 (IOVDD), U11.8 (VCC), U12.5 (VOUT)
+3V3_B: C4.1, C54.1, C55.1, C56.1, C57.1, C58.1, C61.1, C62.1, C64.1, C65.1, C67.1, R72.1, U3.8 (VDD2), U50.1 (IOVDD), U50.10 (IOVDD), U50.22 (IOVDD), U50.33 (IOVDD), U50.42 (IOVDD), U50.43 (ADC_AVDD), U50.44 (VREG_IN), U50.48 (USB_VDD), U50.49 (IOVDD), U51.8 (VCC), U52.5 (VOUT)
+5V_HOST: C1.1, C2.1, F1.2, J2.1 (VBUS), U4.5 (VBUS)
+5V_IN: D2.2 (A), J1.A4 (VBUS), J1.A9 (VBUS), J1.B4 (VBUS), J1.B9 (VBUS)
+5V_SYS_A: C26.1, D2.1 (K), D3.1 (K), F1.1, J6.1, U12.1 (VIN), U12.3 (EN)
BOOT_A: R30.2, SW31.1
BOOT_B: R70.2, SW71.1
CC1_IN: J1.A5 (CC1), R1.1
CC1_PC1: J4.A5 (CC1), R40.1
CC1_PC2: J5.A5 (CC1), R44.1
CC2_IN: J1.B5 (CC2), R2.1
CC2_PC1: J4.B5 (CC2), R41.1
CC2_PC2: J5.B5 (CC2), R45.1
GND_A: C1.2, C2.2, C3.2, C5.2, C6.2, C11.2, C12.2, C14.2, C15.2, C16.2, C17.2, C18.2, C19.2, C20.2, C21.2, C22.2, C23.2, C24.2, C25.2, C26.2, C27.2, D37.1 (K), D38.1 (K), D39.1 (K), J1.A1 (GND), J1.A12 (GND), J1.B1 (GND), J1.B12 (GND), J1.S1 (SHIELD), J2.4 (GND), J2.5 (Shield), J3.6 (VSS), J3.10 (DET_B), J3.11 (SHIELD), J4.A1 (GND), J4.A12 (GND), J4.B1 (GND), J4.B12 (GND), J4.S1 (SHIELD), J6.3, R1.2, R2.2, R40.2, R41.2, R43.2, SW31.2, SW33.2, TP36.1, U3.4 (GND1), U4.2 (GND), U5.2 (GND), U10.19 (TESTEN), U10.57 (GND), U11.4 (GND), U12.2 (GND), Y10.2, Y10.4
GND_B: C4.2, C51.2, C52.2, C54.2, C55.2, C56.2, C57.2, C58.2, C59.2, C60.2, C61.2, C62.2, C63.2, C64.2, C65.2, C66.2, C67.2, D77.1 (K), D78.1 (K), D79.1 (K), J5.A1 (GND), J5.A12 (GND), J5.B1 (GND), J5.B12 (GND), J5.S1 (SHIELD), R44.2, R45.2, SW71.2, SW73.2, TP76.1, U3.5 (GND2), U6.2 (GND), U50.19 (TESTEN), U50.57 (GND), U51.4 (GND), U52.2 (GND), Y50.2, Y50.4
LED_BA_A: D39.2 (A), R39.2
LED_BA_B: D79.2 (A), R79.2
LED_B_A: R39.1, U10.29 (GPIO18)
LED_B_B: R79.1, U50.29 (GPIO18)
LED_GA_A: D38.2 (A), R38.2
LED_GA_B: D78.2 (A), R78.2
LED_G_A: R38.1, U10.28 (GPIO17)
LED_G_B: R78.1, U50.28 (GPIO17)
LED_RA_A: D37.2 (A), R37.2
LED_RA_B: D77.2 (A), R77.2
LED_R_A: R37.1, U10.27 (GPIO16)
LED_R_B: R77.1, U50.27 (GPIO16)
QSPI_SCLK_A: U10.52 (QSPI_SCLK), U11.6 (CLK)
QSPI_SCLK_B: U50.52 (QSPI_SCLK), U51.6 (CLK)
QSPI_SD0_A: U10.53 (QSPI_SD0), U11.5 (DI(IO0))
QSPI_SD0_B: U50.53 (QSPI_SD0), U51.5 (DI(IO0))
QSPI_SD1_A: U10.55 (QSPI_SD1), U11.2 (DO(IO1))
QSPI_SD1_B: U50.55 (QSPI_SD1), U51.2 (DO(IO1))
QSPI_SD2_A: U10.54 (QSPI_SD2), U11.3 (IO2)
QSPI_SD2_B: U50.54 (QSPI_SD2), U51.3 (IO2)
QSPI_SD3_A: U10.51 (QSPI_SD3), U11.7 (IO3)
QSPI_SD3_B: U50.51 (QSPI_SD3), U51.7 (IO3)
QSPI_SS_A: R30.1, U10.56 (QSPI_SS), U11.1 (~CS)
QSPI_SS_B: R70.1, U50.56 (QSPI_SS), U51.1 (~CS)
RGB_DATA: R9.1, U10.8 (GPIO6)
RGB_DIN: J6.2, R9.2
RUN_A: R32.2, SW33.1, U10.26 (RUN)
RUN_B: R72.2, SW73.1, U50.26 (RUN)
SD_CS: J3.2 (DAT3/CD), R5.2, U10.41 (GPIO29_ADC3)
SD_DAT1: J3.8 (DAT1), R7.2
SD_DAT2: J3.1 (DAT2), R8.2
SD_DET: J3.9 (DET_A), U10.38 (GPIO26_ADC0)
SD_MISO: J3.7 (DAT0), R6.2, U10.40 (GPIO28_ADC2)
SD_MOSI: J3.3 (CMD), U10.18 (GPIO15)
SD_SCK: J3.5 (CLK), U10.17 (GPIO14)
SWCLK_A: TP34.1, U10.24 (SWCLK)
SWCLK_B: TP74.1, U50.24 (SWCLK)
SWDIO_A: TP35.1, U10.25 (SWD)
SWDIO_B: TP75.1, U50.25 (SWD)
UART_RX_A: U3.2 (VOA), U10.7 (GPIO5)
UART_RX_B: U3.6 (VOB), U50.7 (GPIO5)
UART_TX_A: U3.3 (VIB), U10.6 (GPIO4)
UART_TX_B: U3.7 (VIA), U50.6 (GPIO4)
USBH_DM: R4.1, U10.5 (GPIO3)
USBH_DM_C: J2.2 (D-), R4.2, U4.3 (I/O2), U4.4 (I/O2)
USBH_DP: R3.1, U10.4 (GPIO2)
USBH_DP_C: J2.3 (D+), R3.2, U4.1 (I/O1), U4.6 (I/O1)
USB_DM_A: R29.1, U10.46 (USB_DM)
USB_DM_B: R69.1, U50.46 (USB_DM)
USB_DM_C_A: J4.A7 (D-), J4.B7 (D-), R29.2, U5.1 (I/O1), U5.6 (I/O1)
USB_DM_C_B: J5.A7 (D-), J5.B7 (D-), R69.2, U6.1 (I/O1), U6.6 (I/O1)
USB_DP_A: R28.1, U10.47 (USB_DP)
USB_DP_B: R68.1, U50.47 (USB_DP)
USB_DP_C_A: J4.A6 (D+), J4.B6 (D+), R28.2, U5.3 (I/O2), U5.4 (I/O2)
USB_DP_C_B: J5.A6 (D+), J5.B6 (D+), R68.2, U6.3 (I/O2), U6.4 (I/O2)
VBUS_PC1: D3.2 (A), J4.A4 (VBUS), J4.A9 (VBUS), J4.B4 (VBUS), J4.B9 (VBUS), R42.1, U5.5 (VBUS)
VBUS_PC2: C66.1, J5.A4 (VBUS), J5.A9 (VBUS), J5.B4 (VBUS), J5.B9 (VBUS), U6.5 (VBUS), U52.1 (VIN), U52.3 (EN)
VBUS_SENSE_A: R42.2, R43.1, U10.36 (GPIO24)
XIN_A: C11.1, U10.20 (XIN), Y10.1
XIN_B: C51.1, U50.20 (XIN), Y50.1
XOUT_A: R13.1, U10.21 (XOUT)
XOUT_B: R53.1, U50.21 (XOUT)
XOUT_R_A: C12.1, R13.2, Y10.3
XOUT_R_B: C52.1, R53.2, Y50.3

Notes on the sheet:
Power input: adapter (J1) OR-ed with PC 1 VBUS
D2 / D3 let the adapter and PC 1 share the load without back-feeding each other. F1 protects the USB-A port.
PC 1: USB-C device port + VBUS sense
MCU-A enumerates on PC 1 (27 ohm series R28 / R29, ESD array U5). GPIO24 sees PC 1 VBUS through R42 / R43.
CC pull-downs: 5.1k = USB device
USB host port: keyboard, mouse, dongle or hub
USBH_DP / USBH_DM come from MCU-A GPIO2 / GPIO3 (PIO-USB host). U4 (USBLC6-2SC6) clamps ESD on the port.
Optional RGB LED header J6
WS2812 / SK6812: 5V, DIN, GND. Data from GPIO6 through R9.
PC 2: USB-C device port (powers side B)
MCU-B enumerates on PC 2 (27 ohm series R68 / R69, ESD array U6) and runs from its VBUS.
Mounting holes
MCU-A: RP2040 (USB host, router, microSD; enumerates on PC 1)
2 MB QSPI flash
3.3 V LDO
decoupling, one per supply pin: DVDD x2, VREG_VOUT, IOVDD x6, USB_VDD, VREG_IN, ADC_AVDD
BOOTSEL
RESET
SWD pads
status LED (red / green / blue)
microSD: shared drive (SPI1)
Shown as a USB drive on the active PC only. 10k pull-ups on CS, MISO and the unused DAT1 / DAT2.
Isolation: GND_A and GND_B never meet
CA-IS3721HS (pin compatible with ADuM1201).
MCU-B: RP2040 (enumerates on PC 2, powered by PC 2)
Notes
GPIO map (same as variant A, one firmware for both) GPIO2 / GPIO3: USB host D+ / D- (PIO-USB, 22 ohm series). GPIO4 / GPIO5: UART1 TX / RX through the isolator. GPIO14 / GPIO15 / GPIO28 / GPIO29: SPI1 SCK / MOSI / MISO and card CS. GPIO26: card detect. GPIO6: external RGB LED (J6). GPIO24: PC 1 VBU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

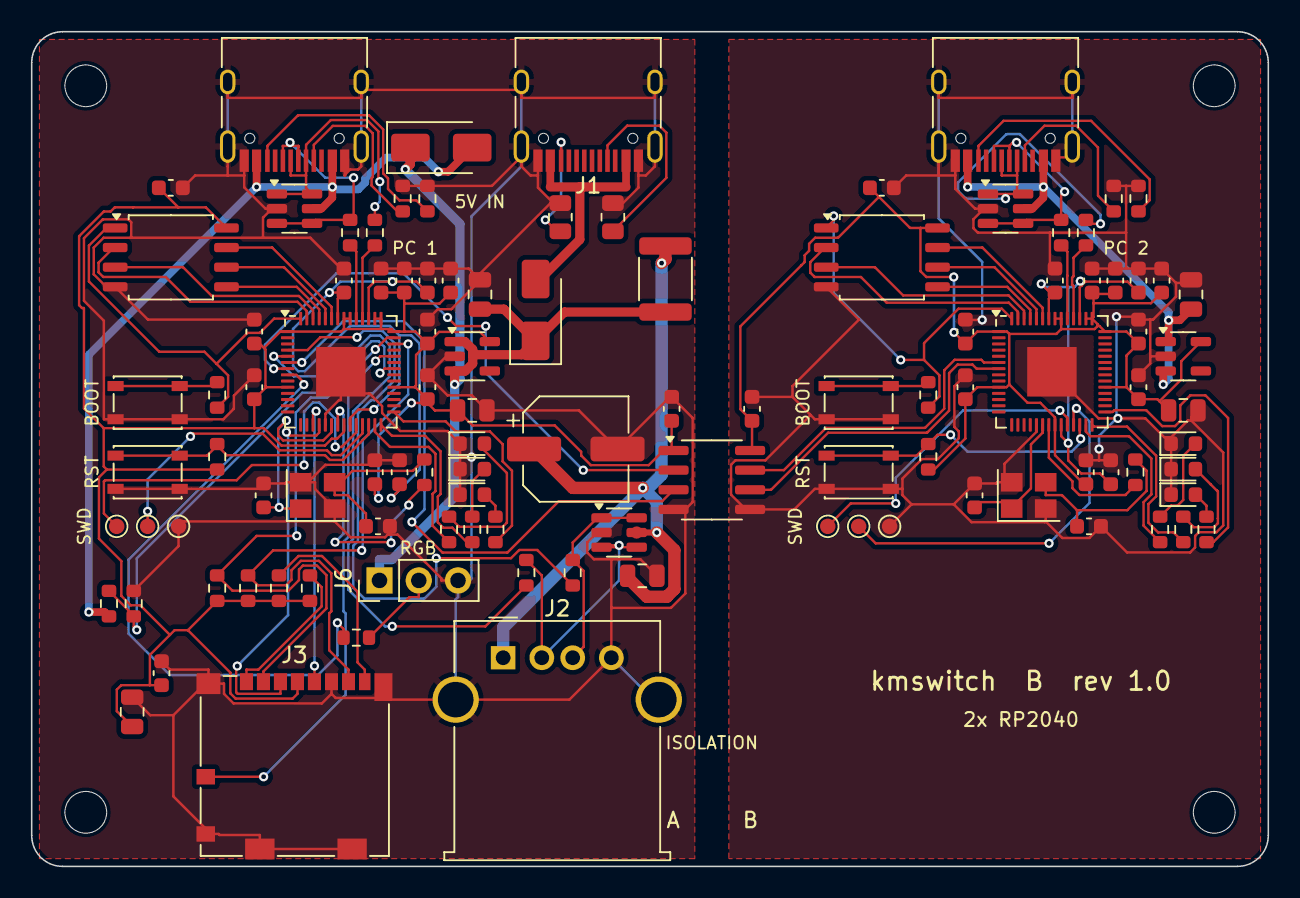
[picture p26: board kmswitch-b.kicad_pcb from above]

Board: 2 copper layers, 80.0 x 54.0 mm, 110 parts (0 on the bottom side), 81 nets.
