KooroshTorabi/KMSwitch/(commit log)

2026-11-02 initial project
    [kmswitch-a-bom.csv, kmswitch-a-bottom.stl, kmswitch-a-lid.stl, kmswitch-a.kicad_pcb, kmswitch-a.kicad_sch, kmswitch-b-bom.csv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]
2026-11-04 Readable schematics for both variants + high-res previews
    - New schematic layout: framed blocks (power, USB ports, MCU, microSD,
    isolation, RGB header, notes), real wires inside each block, named
    power symbols (+5V_IN, +3V3_A, GND_B, ...) and labels between blocks.
    - Layout scripts tools/sch_a.py, tools/sch_b.py on top of tools/schpretty.py;
    tools/sch_build.py writes the sheet and checks it against the design
    netlist (0 differences). Symbol UUIDs are kept, so the PCBs stay linked.
    - Project symbol library gains one power symbol per power net.
    - docs/schematic-a|b: SVG (vector) and 300 dpi PNG, shown in the README.
    - Schematic PDFs regenerated.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
    [kmswitch-a.kicad_sch, kmswitch-b.kicad_sch]
2026-11-04 Configuration file, visual settings editor and docs
    - docs/configuration.md: why the mouse needs per-PC settings but no screen
    resolution (absolute pointer), KMSWITCH.TXT format, defaults, all keys,
    configurable hotkeys (switch, relative mode, speed up/down/reset, open
    editor), speed/aspect/offset/acceleration math, open-editor hotkey per OS.
    - config/KMSWITCH.TXT: default settings file for the microSD card.
    - config/KMSWITCH.HTM: single-file offline editor (any browser): screen
    layout preview, speed/offset sliders, hotkey pickers, live file preview;
    saves in place in Chromium browsers, downloads elsewhere.
    - README: configuration section with editor screenshot.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
2026-11-04 Settings page served by the box, automatic screen measurement
    - Settings page is now served by the box at http://192.168.7.1 over a
    private USB network link (CDC-NCM, RNDIS for Windows 10): saves by
    itself, no file to pick or copy; shows live which PC is connected and
    locks the settings of a PC that is not; draws each PC's real monitors.
    - Automatic measurement: the box switches to each PC (LEDs blink), opens
    /measure and moves the pointer; the page derives the desktop size and
    shape from where the pointer lands and collects every monitor (also
    several of different shape on one PC). Stored as `monitors = ...`.
    - docs/web-api.md: endpoints and measurement protocol.
    - docs/configur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
2026-11-04 Firmware update design, Firmware card on the settings page, BOOT pinholes for case A
    - docs/firmware-update.md: three ways to update (settings page, file on
    the drive, BOOTSEL recovery), physical confirmation with Win+F8 on the
    box's own keyboard, Ed25519-signed .kmsfw bundles, A/B flash slots with
    automatic roll-back, MCU-B updated over the UART, release files.
    - docs/web-api.md: /api/firmware, /api/firmware/cancel, update state in
    /api/status, fw/fw_b/board fields.
    - Settings page: Firmware card (installed version, update check against
    firmware/latest.json on GitHub, one-click update, install from file,
    confirmation banner, progress).
    - firmware/latest.json placeholder + firmwa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
    [kmswitch-a-lid.stl, kmswitch_case.scad]
2026-11-04 Arrange the two PCs like monitors in the OS display settings
    - Settings page: all monitors of both PCs in one pixel-accurate picture;
    drag PC 2 against PC 1, it snaps to monitor edges (and to top / bottom /
    centre alignment) and never overlaps. Quick buttons left / right /
    above / below as a starting point.
    - The pointer crosses only where a PC 1 monitor and a PC 2 monitor touch
    (drawn blue); every other edge stops it, like free edges between
    monitors of different size on one PC. Several touching places possible.
    - Config: `arrangement = X,Y` (PC 2 origin in PC 1 pixels) replaces
    layout / y_offset / x_offset.
    - docs/configuration.md: new "Arranging the two PCs" section, firmware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
2026-11-04 Settings page: screen legend below the drawing (was clipped), exact drag coordinates
    The note under the screen arrangement sat outside the SVG's viewBox and was cut off;
    it is now an HTML line under the drawing with a blue sample line. Drag positions use
    the SVG's own transform, so they stay exact at any window size.
    Claude-Session: https://claude.ai/code/session_01C1cWngWCXFZNztJHGdCDHN
2026-11-04 Hardware rev: USB ESD protection and RGB status LED
    - USBLC6-2SC6 (C7519) on the USB-A host port (both variants) and on the
    PC 1 / PC 2 USB-C ports (variant B)
    - Variant B: the green status LED of each RP2040 becomes a red / green /
    blue trio on GPIO16-18
    - Schematics, placement, routing, DRC, BOM / CPL / gerbers regenerated;
    case B LED window 5 mm
    - Schematic generator: every wired group of a net gets its own label
    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
    [kmswitch-a-bom.csv, kmswitch-a.kicad_pcb, kmswitch-a.kicad_sch, kmswitch-b-bom.csv, kmswitch-b-lid.stl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]
2026-11-04 Firmware, part 1: routing, hotkeys, edge switching, settings file, shared drive
    - Four images: kmswitch-{A,B}-{pc1,pc2}.uf2 (pico-sdk 2.1.1, TinyUSB 0.18,
    Pico-PIO-USB host on core 1 of MCU-A)
    - Portable core with host unit tests: KMSWITCH.TXT parser / writer (same
    output as the settings page), pointer engine with monitors, arrangement,
    touching-edge crossing, corner block and delay, hotkeys, link framing,
    HID descriptor parser, typing for 8 keyboard layouts
    - microSD over SPI with FatFs (exFAT), shown to the active PC only; PC 2
    reaches it block by block over the isolated UART
    - CI workflow: unit tests and firmware build
    Cla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
2026-11-04 Firmware, parts 2 and 3: settings network, web API, measurement, signed updates
    - USB network adapter (RNDIS / CDC-ECM, lwIP, DHCP without gateway or DNS),
    HTTP server, the settings page served gzip-compressed from flash on both
    MCUs; PC 2's API requests and uploads are forwarded to MCU-A over the link
    - Web API per docs/web-api.md: status, config get / put, automatic screen
    measurement (opens the page, moves the pointer, stores the monitors)
    - Bootloader (A/B slots, try counter, hash check, watchdog), images linked for
    both slots, signed .kmsfw bundles (Ed25519 via Monocypher), Win+F8
    confirmation, MCU-B over the link, roll-back and MCU-B re-sync
    - tools/kmsfw.py: keygen, pack, re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
