KooroshTorabi/KMSwitch/(notices)

Notices in the files:
README.md:
Hardware: CERN-OHL-P-2.0
